1m38/keyboards/yacc46/readme.md

# yacc46

yacc46 is a 44-46keys self-made keyboard.

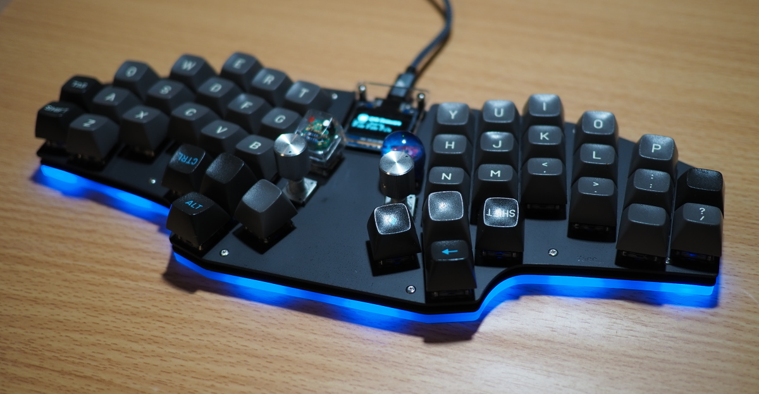
[picture p1: yacc46/docs/img/yacc46.jpg]
yacc46 photo


- [ビルドガイド(日本語)](./docs/buildguide_ja.md)
- [Full-scale drawing](./plate_v1.0/yacc46_fullscale_drawing.pdf)
- [Plate data(SVG)](./plate_v1.0)
- [Schematic](./schema.pdf)
- [KiCad PCB project](./yacc46.pro)
- [QMK Firmware](https://github.com/1m38/qmk_firmware/tree/1m38/yacc46/keyboards/yacc46)

## Notes

The yacc46 PCB project uses these libraries.

- [foostan/kbd](https://github.com/foostan/kbd)

The yacc46 logo uses the [JetBrains Mono](https://github.com/JetBrains/JetBrainsMono) font with some modifications.
