1m38/keyboards/yacc46/plate_v1.0/readme.md

# yacc46 Plate Data (v0.4/v1.0)

v0.4 and v1.0 have the same drawing (edge shapes and switch layouts).

## Full-scale Drawing

- [PDF](./yacc46_fullscale_drawing.pdf)
- [SVG](./yacc46_fullscale_drawing.svg)

## SVG Data

- [Bottom plate](./bottom.svg)
- [Top plate](./top.svg)
- [Cover plate](./cover.svg)

## PCB Top Plate Data

[Kicad project and garver file](./top_pcb)
