1m38/keyboards/yacc46/edge/yacc46-edge.dxf

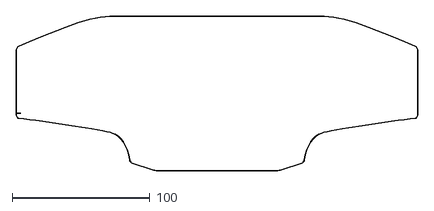
[picture p2: CAD file, 2021-09-11]
yacc46/edge/yacc46-edge.dxf
291.6 x 112.1
