1m38/keyboards/yacc46/edge/yacc46-brd.dxf

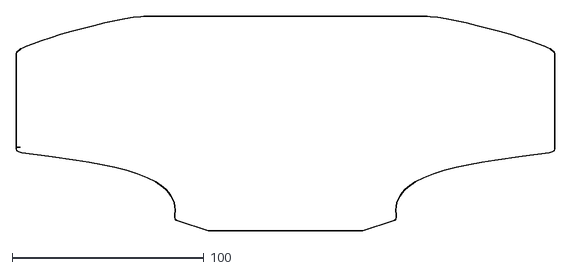
[picture p3: CAD file, 2020-09-14]
yacc46/edge/yacc46-brd.dxf
281.1 x 112.1
