1m38/keyboards/yacc46/plate_v1.0/yacc46_fullscale_drawing.pdf

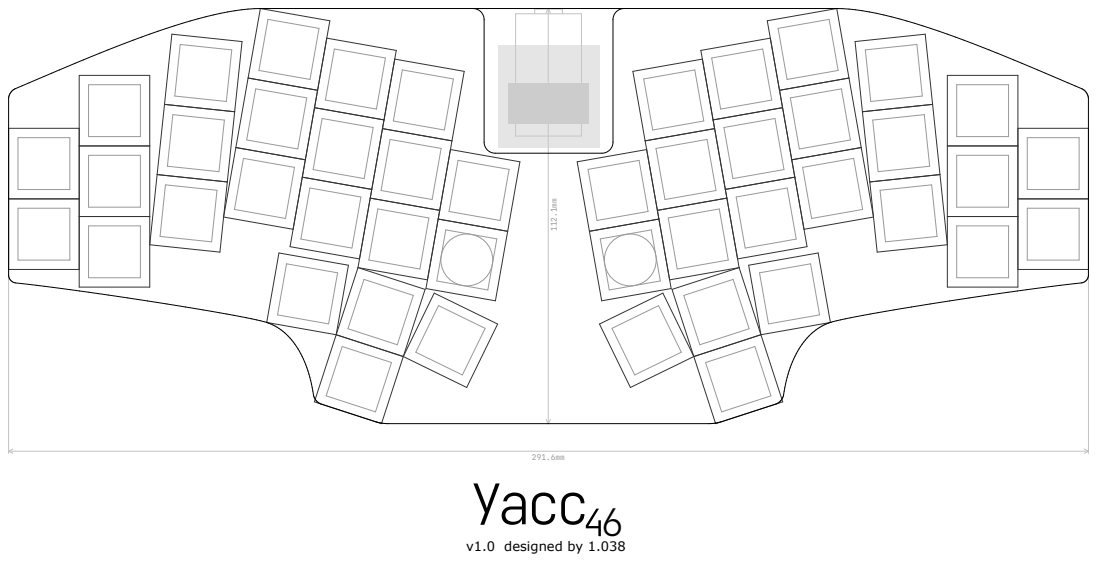
[picture p59: page 1]
291.6mm¹¹².1mm; yacc; v1.0 designed by 1.038
