1m38/keyboards/yacc46/schema.pdf

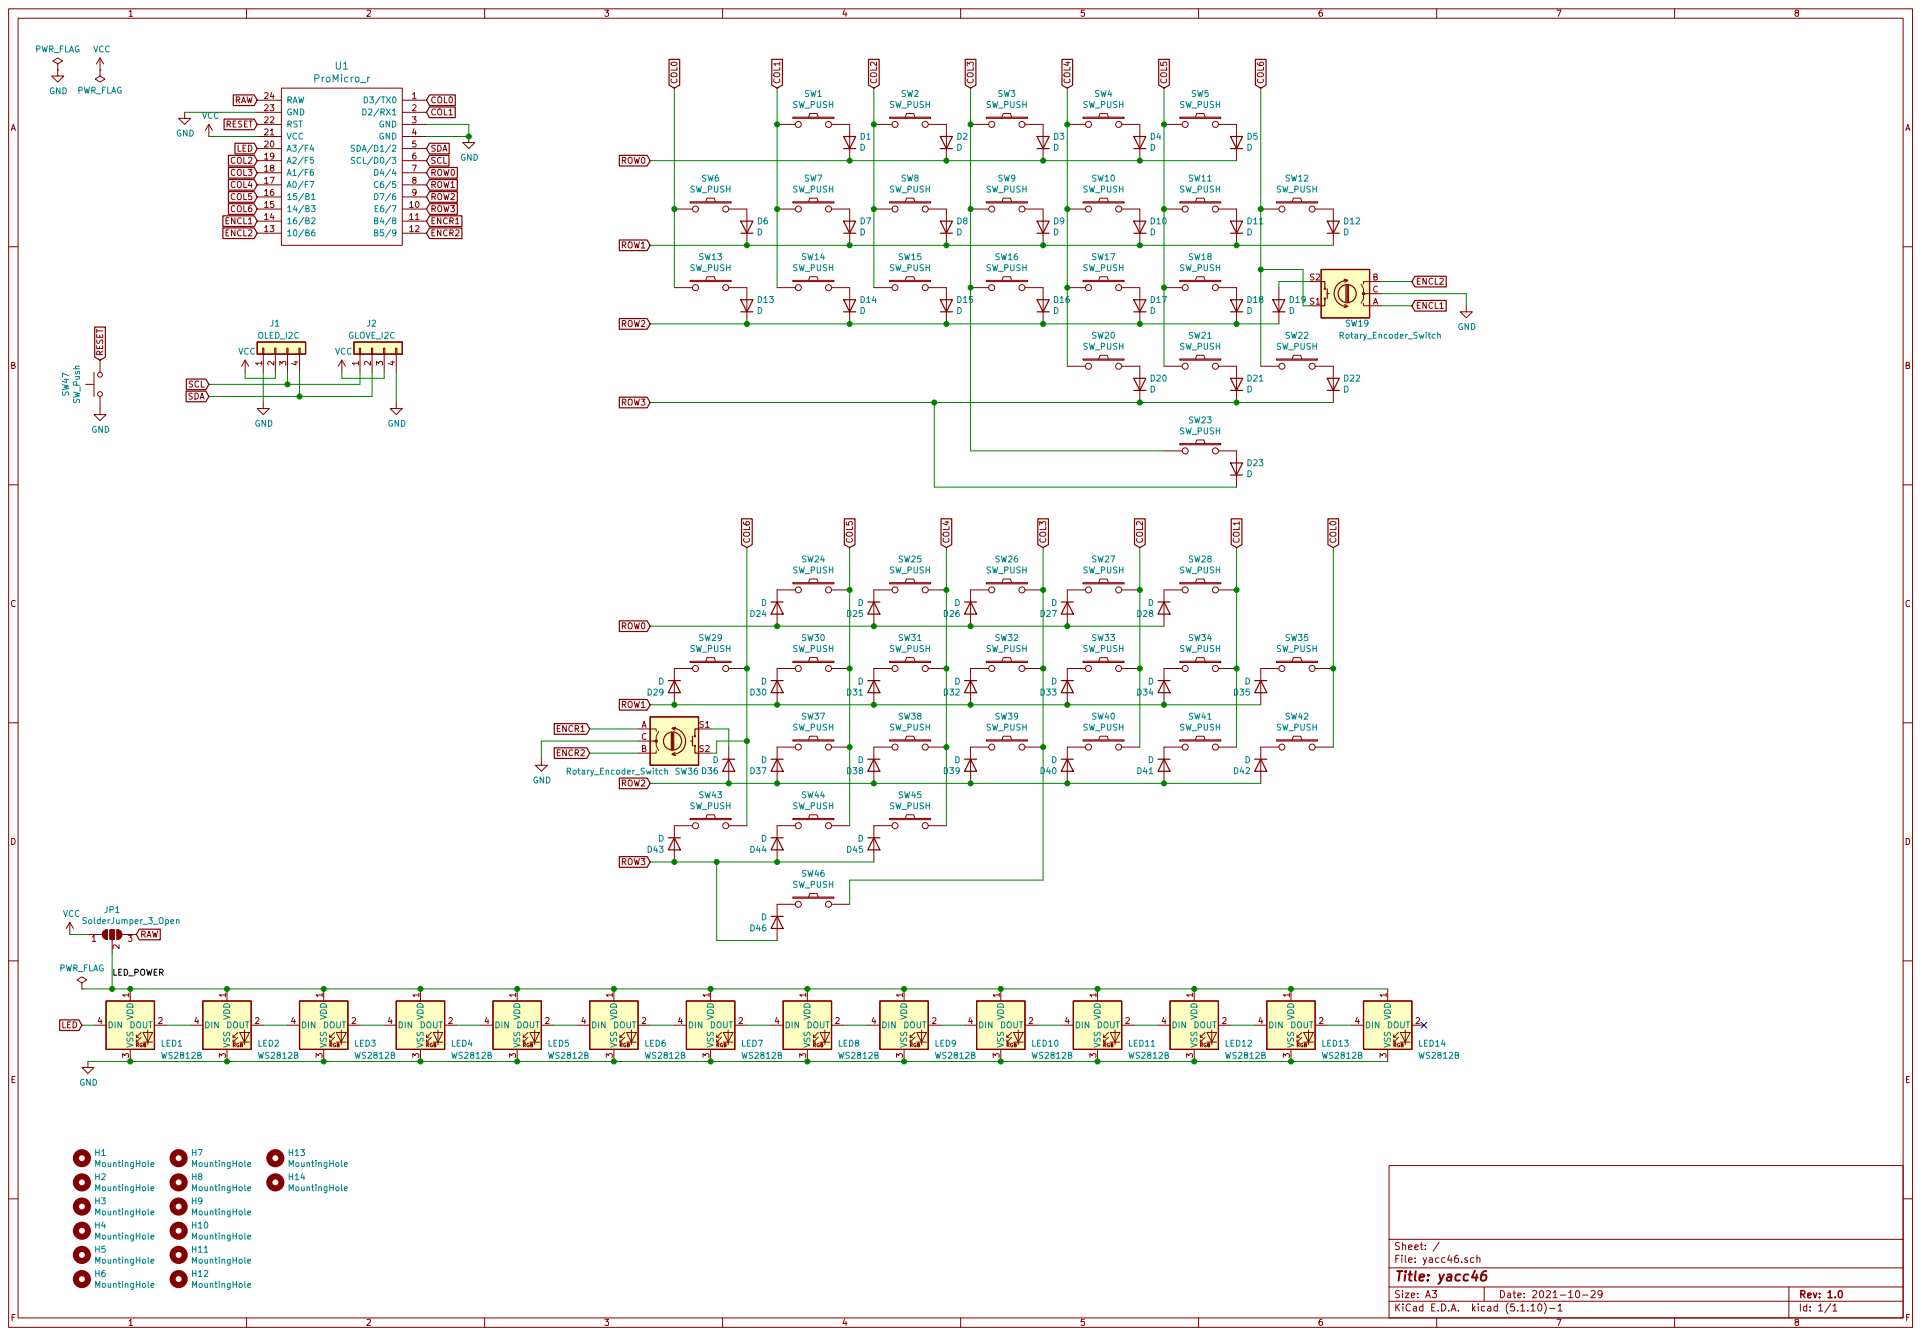
[picture p60: page 1]

SW30 SW_PUSH | SW31 SW_PUSH | SW32 SW_PUSH | SW33 SW_PUSH

SW37 SW_PUSH | SW38 SW_PUSH | SW39 SW_PUSH
