1m38/keyboards/yacc46/yacc46.kicad_pcb

## KiCad design yacc46/yacc46.kicad_pcb (2021-11-15)

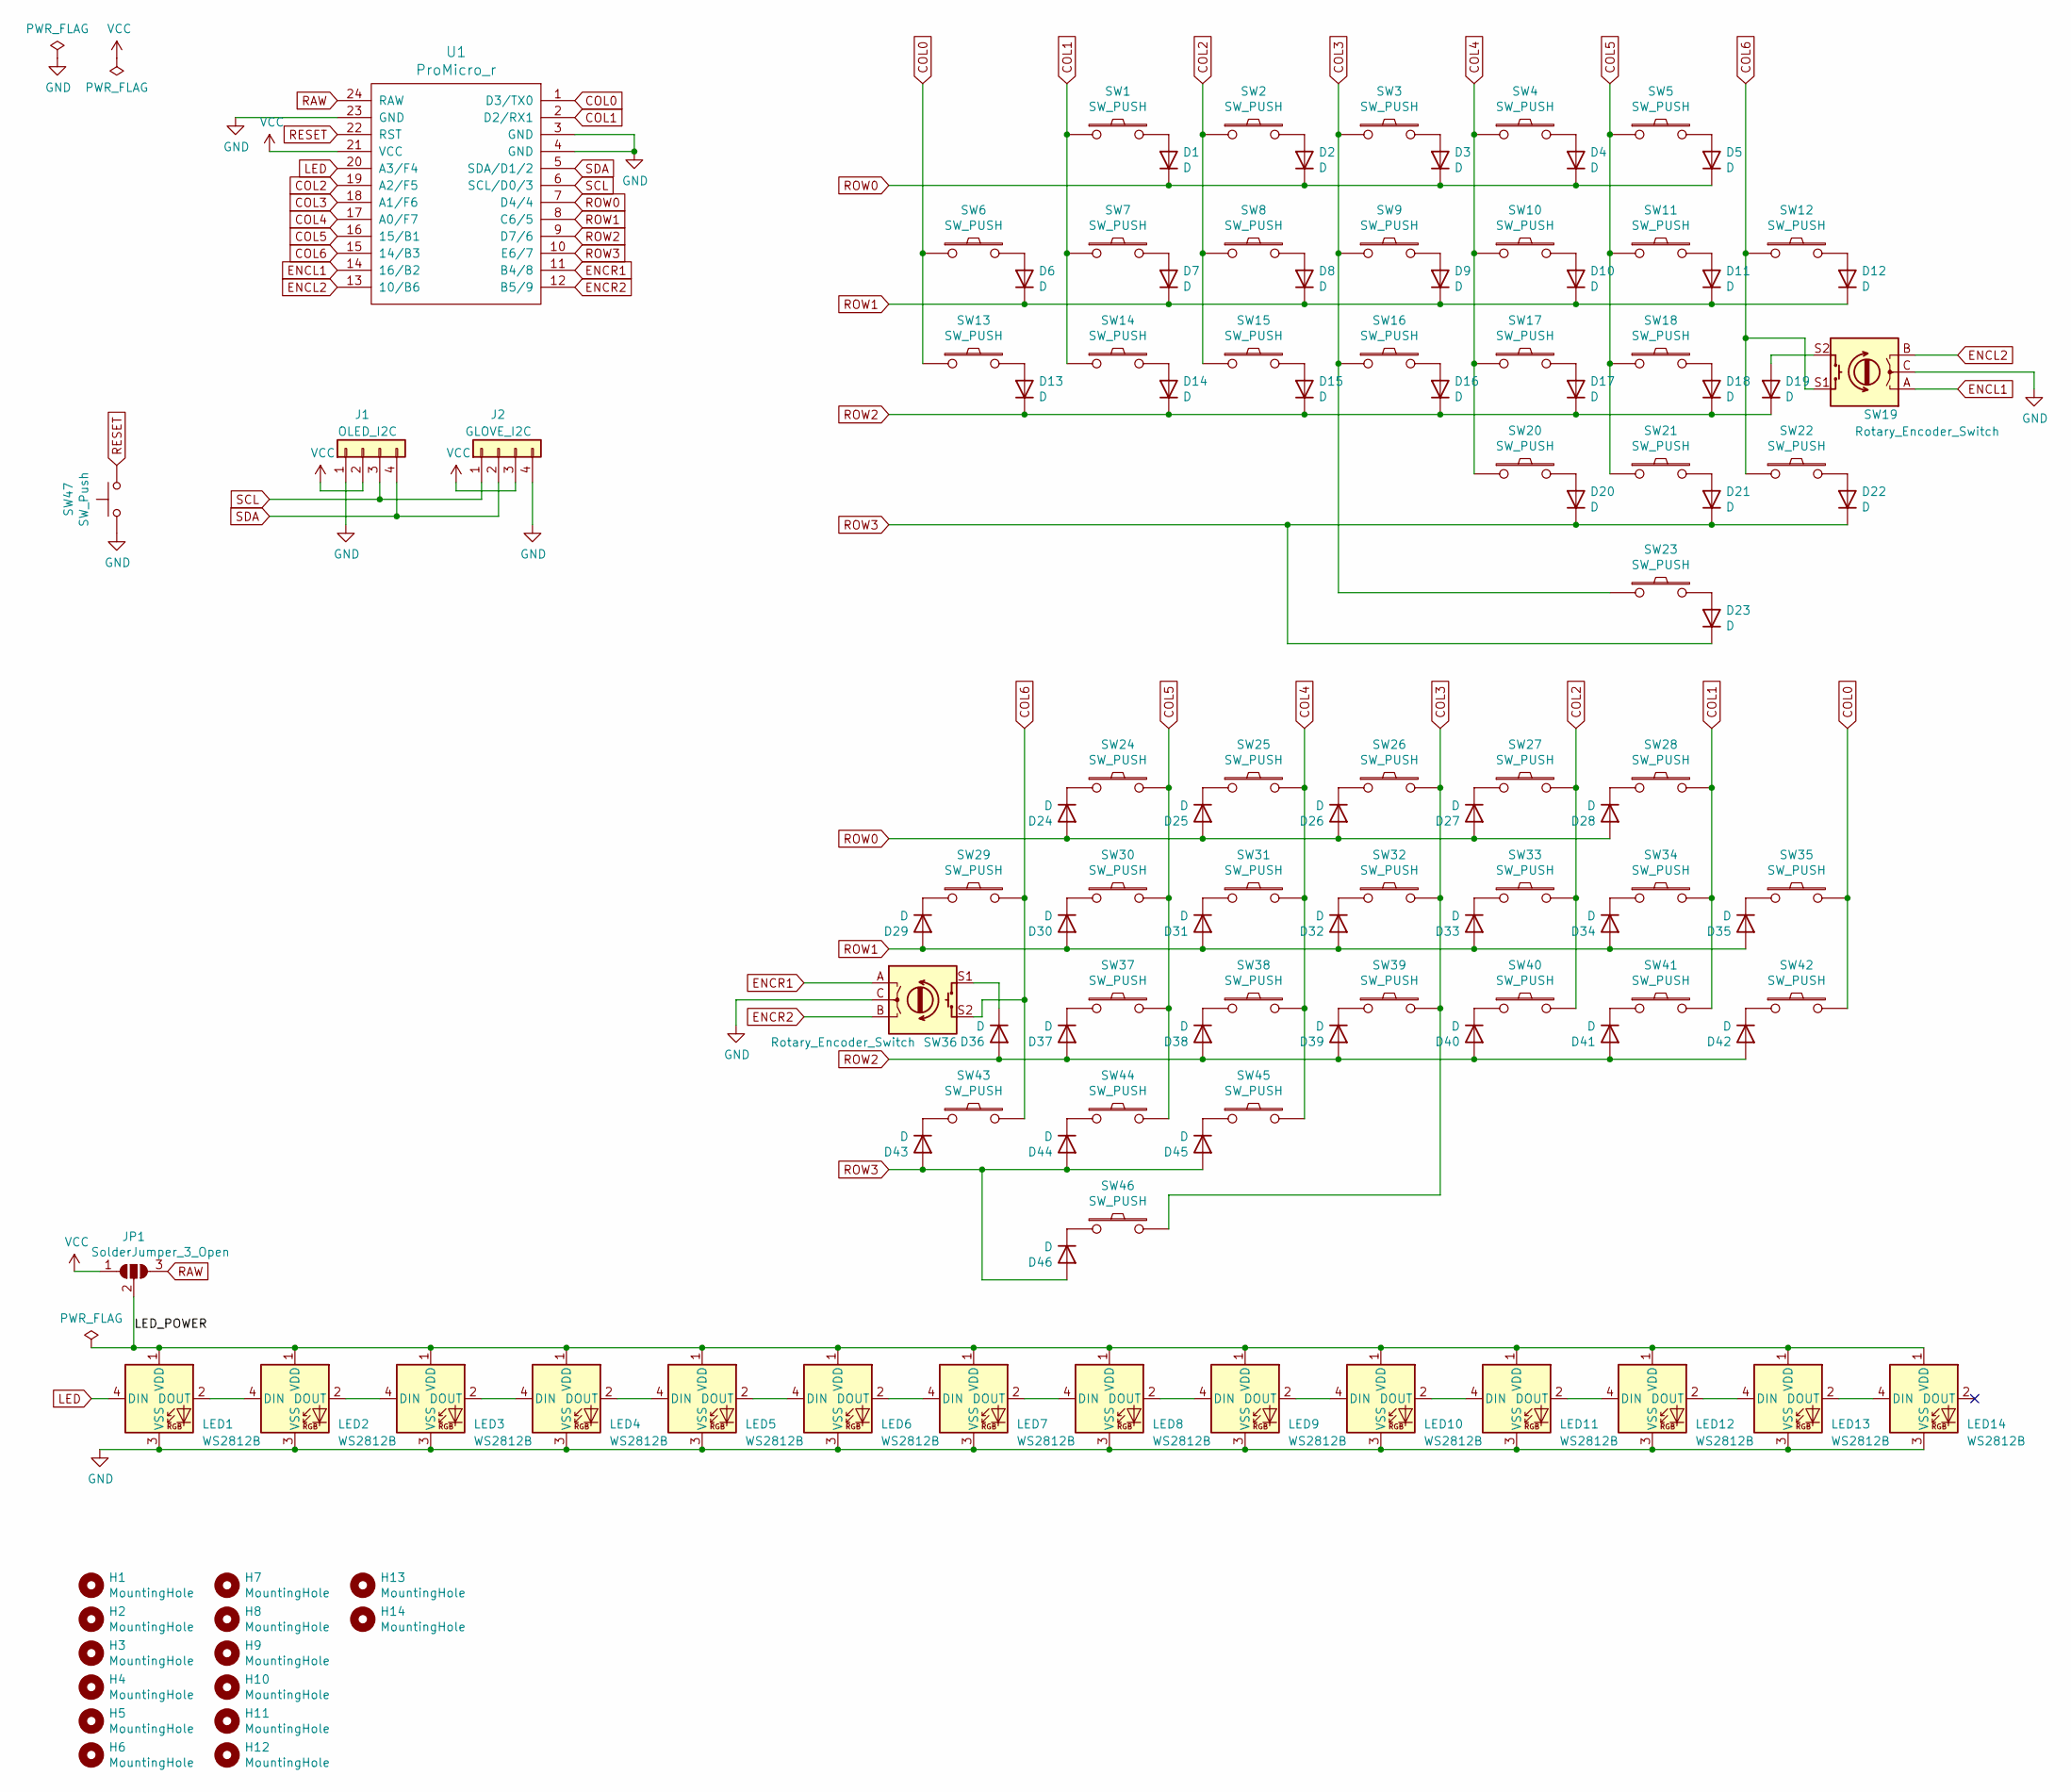
[picture p61: schematic yacc46.sch]

Parts:
D1, D2, D3, D4, D5, D6, D7, D8, D9, D10, D11, D12, D13, D14, D15, D16, D17, D18, D19, D20, D21, D22, D23, D24, D25, D26, D27, D28, D29, D30, D31, D32, D33, D34, D35, D36, D37, D38, D39, D40, D41, D42, D43, D44, D45, D46: D; D3_SMD_v2_silk
H1, H2, H3, H4, H5, H6, H7, H8, H9, H10, H11, H12: MountingHole; M2_HOLE_v2
H13, H14: MountingHole; MountingHole_2.2mm_M2
J1: OLED_I2C; OLED-0.96in
J2: GLOVE_I2C; Grove_I2C
JP1: SolderJumper_3_Open; SolderJumper-3_P2.0mm_Open_TrianglePad1.0x1.5mm
LED1, LED2, LED3, LED4, LED5, LED6, LED7, LED8, LED9, LED10, LED11, LED12, LED13, LED14: WS2812B; LED_WS2812B-PLCC4
SW1, SW2, SW3, SW4, SW5, SW6, SW7, SW8, SW9, SW10, SW11, SW12, SW13, SW14, SW15, SW16, SW17, SW18, SW20, SW21, SW22, SW23, SW24, SW25, SW26, SW27, SW28, SW29, SW30, SW31, SW32, SW33, SW34, SW35, SW37, SW38, SW39, SW40, SW41, SW42, SW43, SW44, SW45, SW46: SW_PUSH; CherryMX_Hotswap_mod
SW19, SW36: Rotary_Encoder_Switch; RotaryEncoder_Alps_EC11E-and-CherryMX-Hotswap
SW47: SW_Push; SW_PUSH_SMD_TVAF06-A020B-R_HandSolder
U1: ProMicro_r; ProMicro_v3

Connections:
/LED_POWER: JP1.2 (C), LED1.1 (VDD), LED2.1 (VDD), LED3.1 (VDD), LED4.1 (VDD), LED5.1 (VDD), LED6.1 (VDD), LED7.1 (VDD), LED8.1 (VDD), LED9.1 (VDD), LED10.1 (VDD), LED11.1 (VDD), LED12.1 (VDD), LED13.1 (VDD), LED14.1 (VDD)
COL0: SW6.1, SW13.1, SW35.2, SW42.2, U1.1 (D3/TX0)
COL1: SW1.1, SW7.1, SW14.1, SW28.2, SW34.2, SW41.2, U1.2 (D2/RX1)
COL2: SW2.1, SW8.1, SW15.1, SW27.2, SW33.2, SW40.2, U1.19 (A2/F5)
COL3: SW3.1, SW9.1, SW16.1, SW23.1, SW26.2, SW32.2, SW39.2, SW46.2, U1.18 (A1/F6)
COL4: SW4.1, SW10.1, SW17.1, SW20.1, SW25.2, SW31.2, SW38.2, SW45.2, U1.17 (A0/F7)
COL5: SW5.1, SW11.1, SW18.1, SW21.1, SW24.2, SW30.2, SW37.2, SW44.2, U1.16 (15/B1)
COL6: SW12.1, SW19.S1, SW22.1, SW29.2, SW36.S2, SW43.2, U1.15 (14/B3)
ENCL1: SW19.A, U1.14 (16/B2)
ENCL2: SW19.B, U1.13 (10/B6)
ENCR1: SW36.A, U1.11 (B4/8)
ENCR2: SW36.B, U1.12 (B5/9)
GND: J1.1, J2.4, LED1.3 (VSS), LED2.3 (VSS), LED3.3 (VSS), LED4.3 (VSS), LED5.3 (VSS), LED6.3 (VSS), LED7.3 (VSS), LED8.3 (VSS), LED9.3 (VSS), LED10.3 (VSS), LED11.3 (VSS), LED12.3 (VSS), LED13.3 (VSS), LED14.3 (VSS), SW19.C, SW36.C, SW47.1, U1.3 (GND), U1.4 (GND), U1.23 (GND)
LED: LED1.4 (DIN), U1.20 (A3/F4)
unnamed: D1.2 (A), SW1.2
unnamed: D2.2 (A), SW2.2
unnamed: D3.2 (A), SW3.2
unnamed: D4.2 (A), SW4.2
unnamed: D5.2 (A), SW5.2
unnamed: D6.2 (A), SW6.2
unnamed: D7.2 (A), SW7.2
unnamed: D8.2 (A), SW8.2
unnamed: D9.2 (A), SW9.2
unnamed: D10.2 (A), SW10.2
unnamed: D11.2 (A), SW11.2
unnamed: D12.2 (A), SW12.2
unnamed: D13.2 (A), SW13.2
unnamed: D14.2 (A), SW14.2
unnamed: D15.2 (A), SW15.2
unnamed: D16.2 (A), SW16.2
unnamed: D17.2 (A), SW17.2
unnamed: D18.2 (A), SW18.2
unnamed: D19.2 (A), SW19.S2
unnamed: D20.2 (A), SW20.2
unnamed: D21.2 (A), SW21.2
unnamed: D22.2 (A), SW22.2
unnamed: D23.2 (A), SW23.2
unnamed: D24.1 (K), SW24.1
unnamed: D25.1 (K), SW25.1
unnamed: D26.1 (K), SW26.1
unnamed: D27.1 (K), SW27.1
unnamed: D28.1 (K), SW28.1
unnamed: D29.1 (K), SW29.1
unnamed: D30.1 (K), SW30.1
unnamed: D31.1 (K), SW31.1
unnamed: D32.1 (K), SW32.1
unnamed: D33.1 (K), SW33.1
unnamed: D34.1 (K), SW34.1
unnamed: D35.1 (K), SW35.1
unnamed: D36.1 (K), SW36.S1
unnamed: D37.1 (K), SW37.1
unnamed: D38.1 (K), SW38.1
unnamed: D39.1 (K), SW39.1
unnamed: D40.1 (K), SW40.1
unnamed: D41.1 (K), SW41.1
unnamed: D42.1 (K), SW42.1
unnamed: D43.1 (K), SW43.1
unnamed: D44.1 (K), SW44.1
unnamed: D45.1 (K), SW45.1
unnamed: D46.1 (K), SW46.1
unnamed: LED1.2 (DOUT), LED2.4 (DIN)
unnamed: LED2.2 (DOUT), LED3.4 (DIN)
unnamed: LED3.2 (DOUT), LED4.4 (DIN)
unnamed: LED4.2 (DOUT), LED5.4 (DIN)
unnamed: LED5.2 (DOUT), LED6.4 (DIN)
unnamed: LED6.2 (DOUT), LED7.4 (DIN)
unnamed: LED7.2 (DOUT), LED8.4 (DIN)
unnamed: LED8.2 (DOUT), LED9.4 (DIN)
unnamed: LED10.2 (DOUT), LED11.4 (DIN)
unnamed: LED9.2 (DOUT), LED10.4 (DIN)
unnamed: LED11.2 (DOUT), LED12.4 (DIN)
unnamed: LED12.2 (DOUT), LED13.4 (DIN)
unnamed: LED13.2 (DOUT), LED14.4 (DIN)
RAW: JP1.3 (B), U1.24 (RAW)
RESET: SW47.2, U1.22 (RST)
ROW0: D1.1 (K), D2.1 (K), D3.1 (K), D4.1 (K), D5.1 (K), D24.2 (A), D25.2 (A), D26.2 (A), D27.2 (A), D28.2 (A), U1.7 (D4/4)
ROW1: D6.1 (K), D7.1 (K), D8.1 (K), D9.1 (K), D10.1 (K), D11.1 (K), D12.1 (K), D29.2 (A), D30.2 (A), D31.2 (A), D32.2 (A), D33.2 (A), D34.2 (A), D35.2 (A), U1.8 (C6/5)
ROW2: D13.1 (K), D14.1 (K), D15.1 (K), D16.1 (K), D17.1 (K), D18.1 (K), D19.1 (K), D36.2 (A), D37.2 (A), D38.2 (A), D39.2 (A), D40.2 (A), D41.2 (A), D42.2 (A), U1.9 (D7/6)
ROW3: D20.1 (K), D21.1 (K), D22.1 (K), D23.1 (K), D43.2 (A), D44.2 (A), D45.2 (A), D46.2 (A), U1.10 (E6/7)
SCL: J1.3, J2.1, U1.6 (SCL/D0/3)
SDA: J1.4, J2.2, U1.5 (SDA/D1/2)
VCC: J1.2, J2.3, JP1.1 (A), U1.21 (VCC)

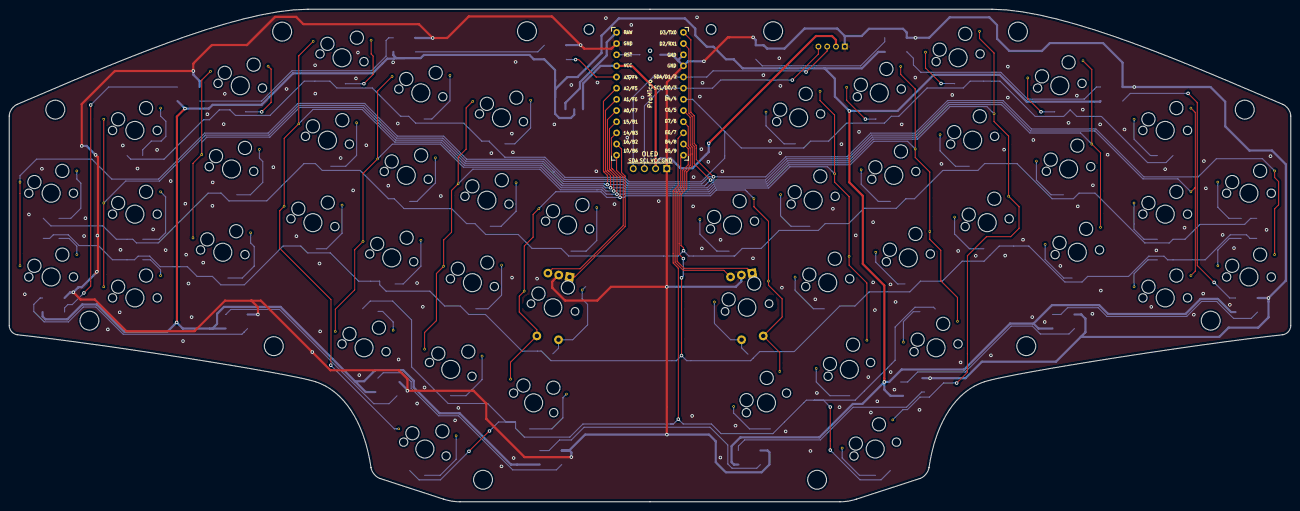
[picture p62: board yacc46.kicad_pcb from above]

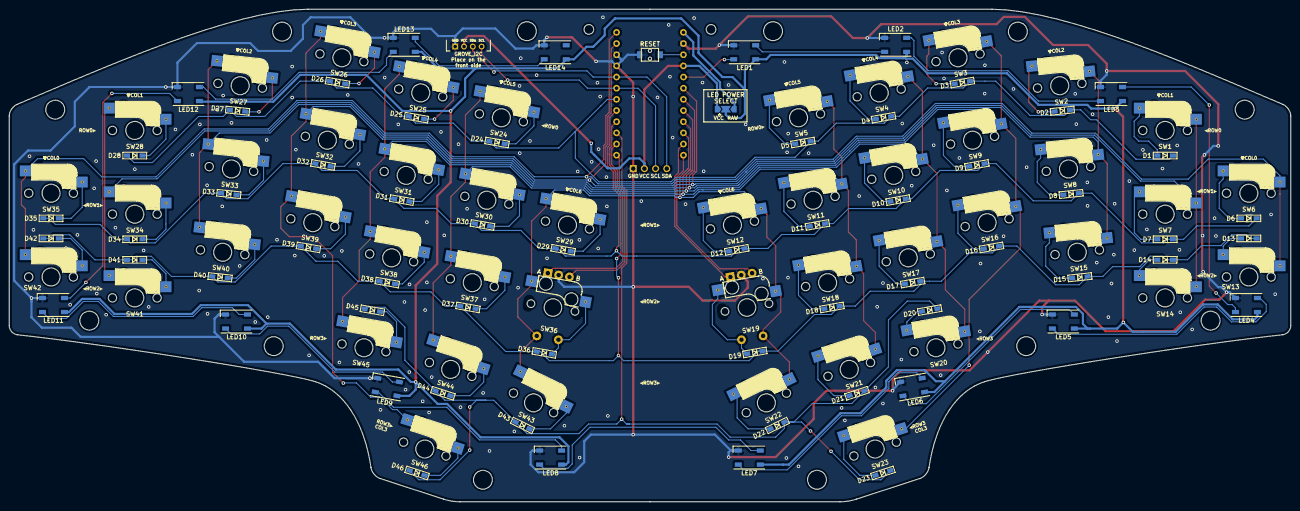
[picture p63: board yacc46.kicad_pcb from below]

Board: 2 copper layers, 291.6 x 112.1 mm, 125 parts (62 on the bottom side), 82 nets.
