1m38/keyboards/yacc46/plate_v0.3/yacc46_plate.kicad_pcb

## KiCad design yacc46/plate_v0.3/yacc46_plate.kicad_pcb (2021-05-30, an earlier design)

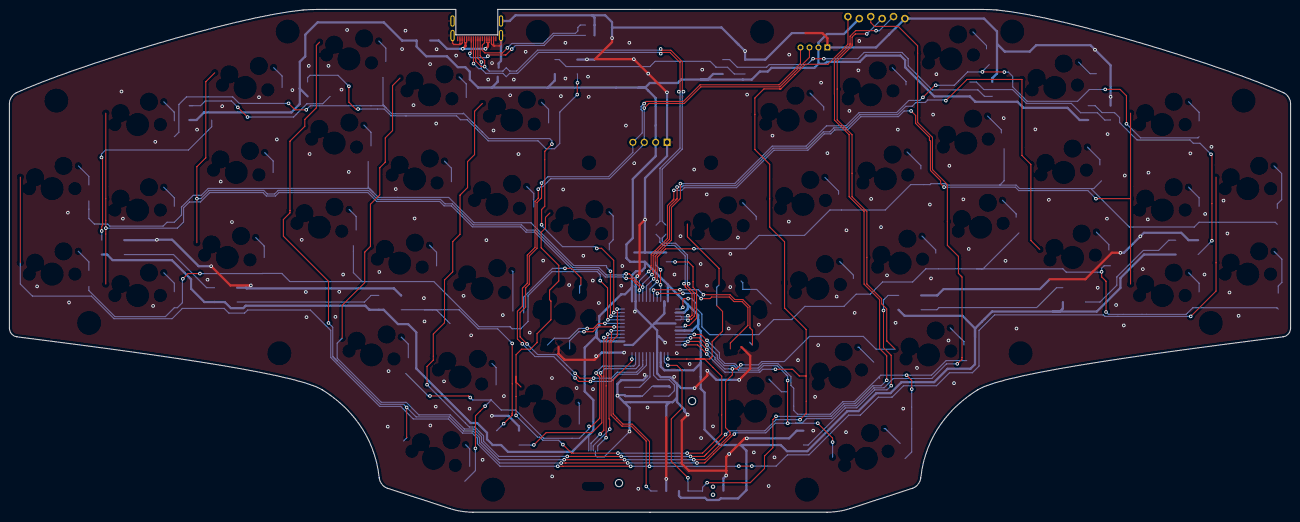
[picture p64: board yacc46_plate.kicad_pcb from above]

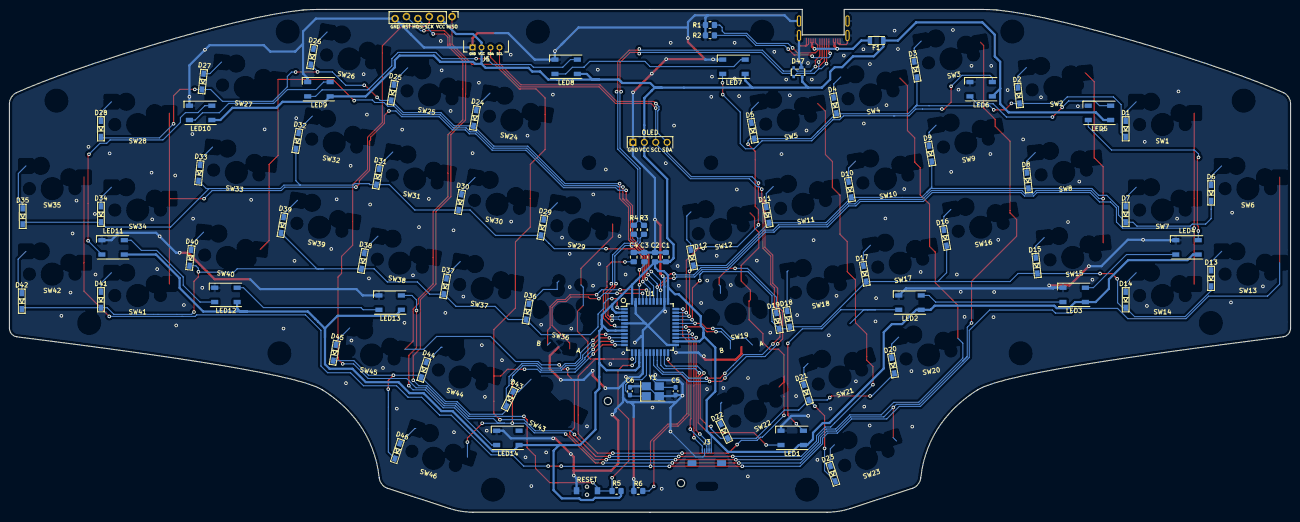
[picture p65: board yacc46_plate.kicad_pcb from below]

Board: 2 copper layers, 285.5 x 112.1 mm, 144 parts (79 on the bottom side), 45 nets.

Parts:
C1: 10u; C_0805_2012Metric_Pad1.18x1.45mm_HandSolder
C2, C3: 0.1u; C_0805_2012Metric_Pad1.18x1.45mm_HandSolder
C4: 1u; C_0805_2012Metric_Pad1.18x1.45mm_HandSolder
C5, C6: 22p; C_0603_1608Metric_Pad1.08x0.95mm_HandSolder
D1, D2, D3, D4, D5, D6, D7, D8, D9, D10, D11, D12, D13, D14, D15, D16, D17, D18, D19, D20, D21, D22, D23, D24, D25, D26, D27, D28, D29, D30, D31, D32, D33, D34, D35, D36, D37, D38, D39, D40, D41, D42, D43, D44, D45, D46: D; D3_SMD_v2_silk
D47: PRTR5V0U2X; PRTR5V0U2X_SOT143B
F1: 500mA; Bouns_PTC_ResettableFuse
H1, H2, H3, H4, H5, H6, H7, H8, H9, H10, H11, H12, H13, H14: MountingHole; M2_ScrewHole
HOLE_ST: Switch_Joycon_Joystick_FPC_hole
J1: USB_C_Receptacle_USB2.0; USB-C_Female_CX90M-16P
J2: OLED_I2C; OLED-0.96in
J3: joystick_switch_joycon; Molex_FPC_CON_0.5mm_5pin_5051100592
J4: AVR-ISP-6; ICSP-Header-ZigZag-Single
J5: GLOVE_I2C; Grove_I2C
LED1, LED2, LED3, LED4, LED5, LED6, LED7, LED8, LED9, LED10, LED11, LED12, LED13, LED14: WS2812B; LED_WS2812B-PLCC4
R1, R2: 5.1k; R_0805_2012Metric_Pad1.20x1.40mm_HandSolder
R3, R4: 22; R_0805_2012Metric_Pad1.20x1.40mm_HandSolder
R5, R6: 10k; R_0805_2012Metric_Pad1.20x1.40mm_HandSolder
ST1: Switch_Joycon_Joystick
SW1, SW2, SW3, SW4, SW5, SW6, SW7, SW8, SW9, SW10, SW11, SW12, SW13, SW14, SW15, SW16, SW17, SW18, SW20, SW21, SW22, SW23, SW24, SW25, SW26, SW27, SW28, SW29, SW30, SW31, SW32, SW33, SW34, SW35, SW37, SW38, SW39, SW40, SW41, SW42, SW43, SW44, SW45, SW46: SW_PUSH; CherryMX_SwitchHole_RoundCorner
SW19, SW36: Rotary_Encoder_Switch; EC11E-and-CherryMX_SwitchHole_RoundCorner
SW47: SW_Push; SW_PUSH_SMD_TVAF06-A020B-R_HandSolder
U1: ATmega32U4-AU; TQFP-44_10x10mm_P0.8mm
Y1: 16MHz; Crystal_SMD_SeikoEpson_FA238-4Pin_3.2x2.5mm_HandSoldering

Connections:
AREF: C3.1, U1.42
COL3: J4.3, U1.9
COL4: J4.4, U1.10
COL5: J4.1, U1.11
DN: R3.1, U1.3
DP: R4.1, U1.4
GND: C1.1, C2.1, C3.2, C4.2, C5.2, C6.2, D47.1, J1.A1, J1.A12, J1.B1, J1.B12, J1.S1, J2.1, J3.2, J4.6, J5.4, LED1.3, LED2.3, LED3.3, LED4.3, LED5.3, LED6.3, LED7.3, LED8.3, LED9.3, LED10.3, LED11.3, LED12.3, LED13.3, LED14.3, R1.2, R2.1, R6.1, SW47.1, U1.5, U1.15, U1.23, U1.35, U1.43, Y1.2, Y1.4
HWB: R6.2, U1.33
JOYSTBT: J3.3, U1.27
JOYSTX: J3.1, U1.26
JOYSTY: J3.4, U1.25
LED: LED1.4, U1.20
unnamed: J1.A5, R1.1
unnamed: J1.B5, R2.2
unnamed: LED1.2, LED2.4
unnamed: LED2.2, LED3.4
unnamed: LED3.2, LED4.4
unnamed: LED4.2, LED5.4
unnamed: LED5.2, LED6.4
unnamed: LED6.2, LED7.4
unnamed: LED7.2, LED8.4
unnamed: LED8.2, LED9.4
unnamed: LED10.2, LED11.4
unnamed: LED9.2, LED10.4
unnamed: LED11.2, LED12.4
unnamed: LED12.2, LED13.4
unnamed: LED13.2, LED14.4
RESET: J4.5, R5.2, SW47.2, U1.13
ROWL0: D1.1, D2.1, D3.1, D4.1, D5.1, U1.32
ROWL1: D6.1, D7.1, D8.1, D9.1, D10.1, D11.1, D12.1, U1.31
ROWL2: D13.1, D14.1, D15.1, D16.1, D17.1, D18.1, D19.1, U1.30
ROWL3: D20.1, D21.1, D22.1, D23.1, U1.21
ROWR0: D24.1, D25.1, D26.1, D27.1, D28.1, U1.38
ROWR1: D29.1, D30.1, D31.1, D32.1, D33.1, D34.1, D35.1, U1.39
ROWR2: D36.1, D37.1, D38.1, D39.1, D40.1, D41.1, D42.1, U1.1
ROWR3: D43.1, D44.1, D45.1, D46.1, U1.8
SCL: J2.3, J5.2, U1.18
SDA: J2.4, J5.1, U1.19
UCAP: C4.1, U1.6
UDN: D47.3, J1.A7, J1.B7, R3.2
UDP: D47.2, J1.A6, J1.B6, R4.2
UVBUS: F1.2, J1.A4, J1.A9, J1.B4, J1.B9
VBUS: C1.2, C2.2, D47.4, F1.1, J2.2, J3.5, J4.2, J5.3, LED1.1, LED2.1, LED3.1, LED4.1, LED5.1, LED6.1, LED7.1, LED8.1, LED9.1, LED10.1, LED11.1, LED12.1, LED13.1, LED14.1, R5.1, U1.2, U1.7, U1.14, U1.24, U1.34, U1.44
XTAL1: C5.1, U1.17, Y1.3
XTAL2: C6.1, U1.16, Y1.1
