1m38/keyboards/(commit log)

2020-09-06 基板作成、キー配置スクリプト作成
    [falx46.kicad_pcb, falx46.sch]
2020-09-06 ライブラリの参照を修正
    [falx46.sch]
2020-09-07 回路図を更新
    - Grove I2C端子用ホールを追加
    - LEDテープ用接点を追加
    [falx46.kicad_pcb, falx46.sch]
2020-09-08 輪郭線を追加
    [falx46-brd.dxf, falx46.kicad_pcb]
2020-09-08 一部パーツを配置
    [falx46.kicad_pcb]
2020-09-08 LEDを2つ追加
    [falx46.kicad_pcb, falx46.sch]
2020-09-08 オートルータ準備
    [falx46.kicad_pcb]
2020-09-13 仮配線・Mounting Hole追加
    [falx46.kicad_pcb]
2020-09-13 一旦配線を完了
    [falx46.kicad_pcb, falx46.sch]
2020-09-13 配線完了
    [falx46.kicad_pcb, falx46.sch]
2020-09-14 シルク調整中
    [falx46.kicad_pcb, falx46.sch]
2020-09-14 oled用ネジ穴追加、各種調整、クレジット追加
    [falx46.kicad_pcb]
2020-09-14 プロジェクト名をリネーム
    [yacc46-brd.dxf, yacc46.kicad_pcb, yacc46.sch]
2020-09-14 基板外形を変更
    [yacc46-brd.dxf, yacc46.kicad_pcb]
2020-09-14 トッププレートを作成(USB, TRRSコネクタ未カット)
    [yacc46_plate.kicad_pcb]
2020-09-15 USBコネクタをCX70M-24P1に変更
    [yacc46.kicad_pcb, yacc46.sch]
2020-09-17 おおよそPCBの最終調整完了
    [yacc46.kicad_pcb, yacc46.sch]
2020-09-17 v0.1発注データ
    [yacc46-B_Cu.gbr, yacc46-B_Mask.gbr, yacc46-B_SilkS.gbr, yacc46-Edge_Cuts.gbr, yacc46-F_Cu.gbr, yacc46-F_Mask.gbr, yacc46-F_SilkS.gbr, yacc46-NPTH.drl]
2020-09-18 プレートデータを作成
    [yacc46.kicad_pcb, yacc46_plate.kicad_pcb]
2020-10-04 make yacc46 directory
    [yacc46-B_Cu.gbr, yacc46-B_Mask.gbr, yacc46-B_SilkS.gbr, yacc46-Edge_Cuts.gbr, yacc46-F_Cu.gbr, yacc46-F_Mask.gbr, yacc46-F_SilkS.gbr, yacc46-NPTH.drl]
2020-10-04 add kicad libraries as submodules
2020-10-04 add 1m38_kbd footprint library
2020-10-04 リセットスイッチ・水晶のフットプリントを変更
    [yacc46.sch]
2020-10-05 ロータリーエンコーダ部分のスイッチをMillMaxソケットに対応
    スイッチ用スルーホールを直径1.6mmに変更
    [yacc46.kicad_pcb]
2020-10-12 OLEDのフットプリントを修正
    [yacc46.kicad_pcb]
2020-10-12 配線を修正
    [yacc46.kicad_pcb, yacc46.sch]
2020-11-01 フットプリントを修正
2020-11-06 key_arrange.pyを変更、フットプリントの位置を微調整
    [yacc46.kicad_pcb, yacc46.sch]
2020-11-08 GND配線を修正
    [yacc46.kicad_pcb]
2020-11-08 クレジットを追加
    [yacc46.kicad_pcb]
2020-11-11 GND viaを追加
    [yacc46.kicad_pcb]
2020-11-11 GND, USB配線を修正
    [yacc46.kicad_pcb]
2020-11-12 基板を調整
    [yacc46.kicad_pcb]
2020-11-12 v0.2発注データ
    [yacc46-B_Cu.gbl, yacc46-B_Mask.gbs, yacc46-B_SilkS.gbo, yacc46-Edge_Cuts.gm1, yacc46-F_Cu.gtl, yacc46-F_Mask.gts, yacc46-F_SilkS.gto, yacc46-NPTH.drl]
2020-11-14 v0.1 plateデータのディレクトリを変更
2020-11-18 プレート元データを作成
    [yacc46_plate.kicad_pcb]
2020-11-18 プレートデータ(Sandwich)を作成
2020-11-23 ロータリーエンコーダ兼用スイッチ穴のフットプリントを修正
    [yacc46_plate.kicad_pcb]
2020-11-23 プレートデータ(Sandwitch)を修正
2021-03-07 yacc46の回路図を修正
    - ESD保護ダイオードPRTR5V0U2Xを追加
    - USBレセプタクルをCX90M-16Pに変更
    - LEDをWS2812Bに変更
    - MountingHoleを追加
    [yacc46.sch]
2021-03-07 yacc46 PCB: MountingHoleを修正
    - 中央の穴を削除
    - リファレンスを修正
    [yacc46.kicad_pcb]
2021-03-07 yacc46 回路図: LED13,14を忘れていたので追加
    [yacc46.sch]
2021-05-10 yacc46 回路図: Switchジョイコンのジョイスティックを追加 (ピン配置は仮)
    [yacc46.sch]
2021-05-10 FPCコネクタのフットプリントを作成
    [yacc46.sch]
2021-05-10 ジョイコン本体のフットプリントを作成
2021-05-10 フットプリント追加・ジョイコン用にキー配置スクリプトを調整
2021-05-11 ESDダイオードのフットプリントを変更
    [yacc46.sch]
2021-05-11 [WIP]仮配置
    [yacc46.kicad_pcb]
2021-05-11 基板外形を変更
    ジョイコン配置によって横幅が広がったので、ついでに基板外形を引き直した
    [yacc46-edge.dxf, yacc46.kicad_pcb]
2021-05-15 [WIP]配線中
    [yacc46.kicad_pcb]
2021-05-23 v0.3発注版
    [yacc46.kicad_pcb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]
2021-05-30 sandwitchプレートデータを作成
    [yacc46_plate.kicad_pcb]
2021-05-30 sandwitchプレートデータを分割
2021-06-28 update v0.3 plate data
    add sandwitch/top_grove (top plate with grove connector space)
2021-08-28 update yacc46 schematic
    [yacc46.sch]
2021-09-05 arrange keyswitches
    [yacc46.kicad_pcb]
2021-09-11 update edge (shorten the width)
    [yacc46-edge.dxf, yacc46.kicad_pcb, yacc46.sch]
2021-09-11 modify leds and holes position
    [yacc46.kicad_pcb]
2021-09-11 revert keyswitch footprint
    [yacc46.kicad_pcb]
2021-09-11 flip right hand side's diodes direction
    [yacc46.kicad_pcb, yacc46.sch]
2021-09-11 modify diode positions
    [yacc46.kicad_pcb]
2021-09-12 modify led positions
    [yacc46.kicad_pcb]
2021-09-12 modify PCB design rules
    [yacc46.kicad_pcb, yacc46.sch]
2021-09-12 partially wired
    [yacc46.kicad_pcb]
2021-09-12 modify footprint of rotary encoders (use hot-swap socket)
    [yacc46.kicad_pcb]
2021-09-12 modify hole positions
    [yacc46.kicad_pcb]
2021-09-12 wire PCB
    [yacc46.kicad_pcb]
2021-09-12 add logo
    [yacc46.kicad_pcb]
2021-09-19 move cover-plate screw hole
    [yacc46.kicad_pcb, yacc46.sch]
2021-09-19 create PCB top-plate data
    [yacc46_plate.kicad_pcb]
2021-09-19 move v0.3 plate data
    [yacc46_plate.kicad_pcb]
2021-09-21 garver files
    [yacc46.kicad_pcb, yacc46_plate.kicad_pcb]
2021-09-26 modify some Edge.Cuts layer footprints
2021-09-26 move directory of plate_v0.4 pcb project
    [yacc46_plate.kicad_pcb]
2021-09-26 plate svg data
2021-10-12 enable to change encoders' action with VIA
2021-10-23 move some diodes
    [yacc46.kicad_pcb]
2021-10-23 modify some wiring
    [yacc46.kicad_pcb]
2021-10-23 add row/col number silks
    [yacc46.kicad_pcb]
2021-10-29 yacc46 v1.0 garver
    [yacc46.kicad_pcb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]
2021-10-29 yacc46 v1.0 plate: add copper on the back side
    [yacc46_plate.kicad_pcb]
2021-10-29 rename plate data v0.4 -> v1.0
    [yacc46_plate.kicad_pcb]
2021-10-29 add readme for plate data
2021-10-29 add revision to schema.pdf
    [yacc46.kicad_pcb, yacc46.sch]
